TogoresDreemurr/Mocowanie-na-reke-3d-model/step/prowadnica_palcow_lewa.step

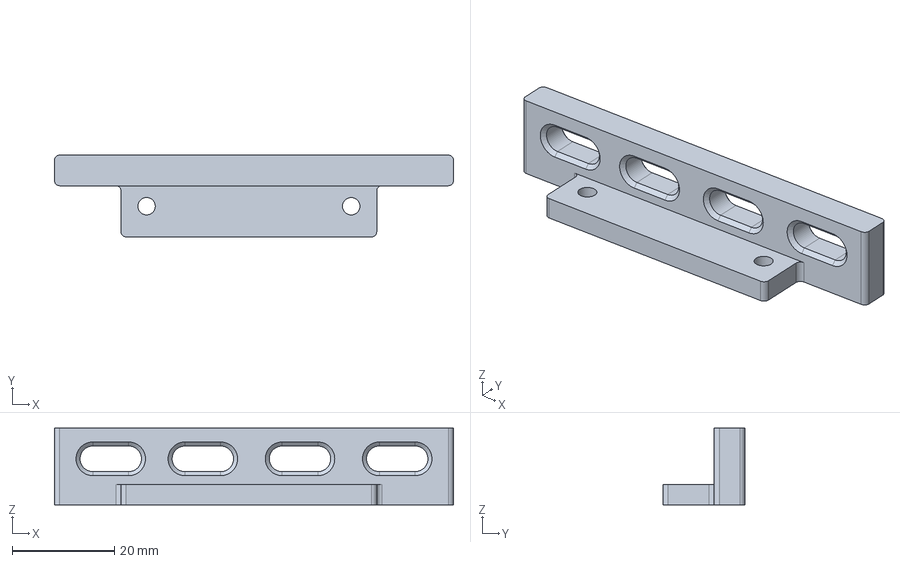
[picture p5: CAD file, 2026-10-05]
step/prowadnica_palcow_lewa.step
78.0 x 16.0 x 15.0 mm
