TogoresDreemurr/Mocowanie-na-reke-3d-model/step/plytka_dloni_prawa.step

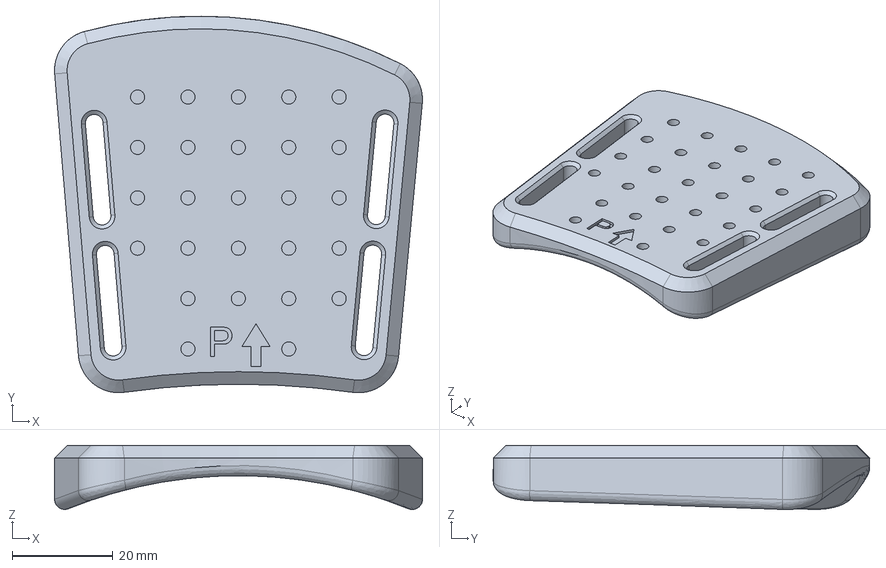
[picture p6: CAD file, 2026-10-05]
step/plytka_dloni_prawa.step
73.0 x 74.7 x 12.7 mm
