TogoresDreemurr/Mocowanie-na-reke-3d-model/(list of files, cad)

Other CAD files:
step/plytka_dloni_lewa.step
step/prowadnica_palcow_prawa.step
stl/plytka_dloni_lewa.stl
stl/plytka_dloni_prawa.stl
stl/prowadnica_palcow_lewa.stl
stl/prowadnica_palcow_prawa.stl
